m0tei/StrainGauge/StrainGauge.kicad_pcb

## KiCad design StrainGauge.kicad_pcb (2026-11-06)

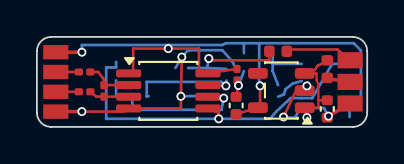
[picture p5: board StrainGauge.kicad_pcb from above]

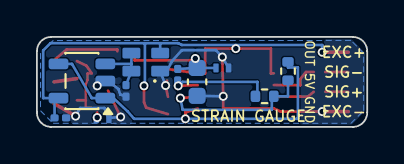
[picture p6: board StrainGauge.kicad_pcb from below]

Board: 2 copper layers, 18.3 x 5.0 mm, 22 parts (10 on the bottom side), 14 nets.

Parts:
C1, C2: 1u 10V; C_0402_1005Metric
C3, C4, C7: 100n 10V; C_0201_0603Metric
C5: 330n 16V; C_0603_1608Metric
C6: 10n 10V; C_0201_0603Metric
D1, D2: ESD 5.5V; TVS_X1SON-2_DPY
FB1, FB2: 600R; L_0402_1005Metric
J1: To ADC / 5 V; CablePads_1x03
J2: To rod; GaugePads_1x04
R1: 665R 0.02%; R_0402_1005Metric
R2: 100k 0.05%; R_0402_1005Metric
R4: 1k; R_0201_0603Metric
R5, R6: 100R; R_0201_0603Metric
RN1: 10k/30k; ACAS_0606
U1: TPS7A2033PDBVR; TI_DBV0005A_SOT-23-5
U2: MCP6N16-100E/MS; Microchip_MS_MSOP-8
U3: OPA388QDBVRQ1; TI_DBV0005A_SOT-23-5

Connections:
+3V3: C2.1, C3.1, C7.1, J2.1, RN1.2, U1.5 (OUT), U2.1, U2.8, U3.5
+5V: C1.1, D1.2, FB1.1, U1.1 (IN), U1.3 (EN)
/OUT: C5.1, D2.2, FB2.1, R4.2
/OUT_J1: FB2.2, J1.2
/SIG+: J2.2, R5.1
/SIG-: J2.3, R6.1
/VDIV: C4.1, RN1.3, RN1.4, U3.3
/VFG: R1.1, R2.2, U2.6
/VIN_J1: FB1.2, J1.1
/VO: R2.1, R4.1, U2.7
/VREF: R1.2, U2.5, U3.1, U3.4
GND: C1.2, C2.2, C3.2, C4.2, C5.2, C7.2, D1.1, D2.1, J1.3, J2.4, RN1.1, U1.2 (GND), U2.4, U3.2
unnamed: C6.2, R6.2, U2.2
unnamed: C6.1, R5.2, U2.3
