m0tei/StrainGauge/(commit log)

2026-11-04 Add StrainGauge KiCad project
    [StrainGauge.kicad_pcb, StrainGauge.kicad_sch, StrainGauge_BOM.csv]
2026-11-05 Swap in MCP6N16 amplifier and TPS7A2033 regulator
    Replace U2 (INA333-Q1) with MCP6N16-100E/MS and U1 (TLV73333-Q1) with
    TPS7A2033PDBVR. Replace R1 with RN2, a matched ACAS 0612 array that sets
    gain 201 from the external RF/RG ratio.
    Move R4 to the back and re-place the parts around U1 so all courtyards
    clear. Update the BOM and board renders.
    [StrainGauge.kicad_pcb, StrainGauge.kicad_sch, StrainGauge_BOM.csv]
2026-11-05 Remove unused STM32 archive and TLV73333 symbol
    [StrainGauge.kicad_pcb, StrainGauge.kicad_sch]
2026-11-05 Move U2 text clear of the GND symbol
    [StrainGauge.kicad_sch]
2026-11-05 Move RN2 beside U2 and tidy the amplifier section
    [StrainGauge.kicad_sch]
2026-11-05 Replace RN2 with matched 0402 gain resistors
    Use Susumu RG1005N 0.05% +/-10 ppm/K parts for R1 and R2, placed side by
    side on the back under U2. This frees board space and sets gain to 201.4.
    [StrainGauge.kicad_pcb, StrainGauge.kicad_sch, StrainGauge_BOM.csv]
2026-11-05 Add README with board photos and design explanation
2026-11-06 Change gain to 151 and VREF to 0.825 V for lopsided load
    Expected load is 3000 ue compression and 300 ue extension, and gain 201
    clipped at 1850 ue. Set R1 to 665R for gain 151.4 and use a 10k/30k RN1
    for VREF = 3.3 V / 4. Swap SIG+ and SIG- at the bridge so compression
    drives the output up.
    RN1 is now polarized, so add a pin 1 mark to the ACAS 0606 footprint.
    Update the BOM, README and images, and add the amplifier calculations.
    [StrainGauge.kicad_pcb, StrainGauge.kicad_sch, StrainGauge_BOM.csv]
